mrbearnetflix/mrbearnetflix/README.md

## Netflix Connected Mr. Bear
Project site at [mrbear.netflix.com](http://mrbear.netflix.com)
