mrbearnetflix/mrbearnetflix/ee/Cellular_Bear_Schematic.pdf

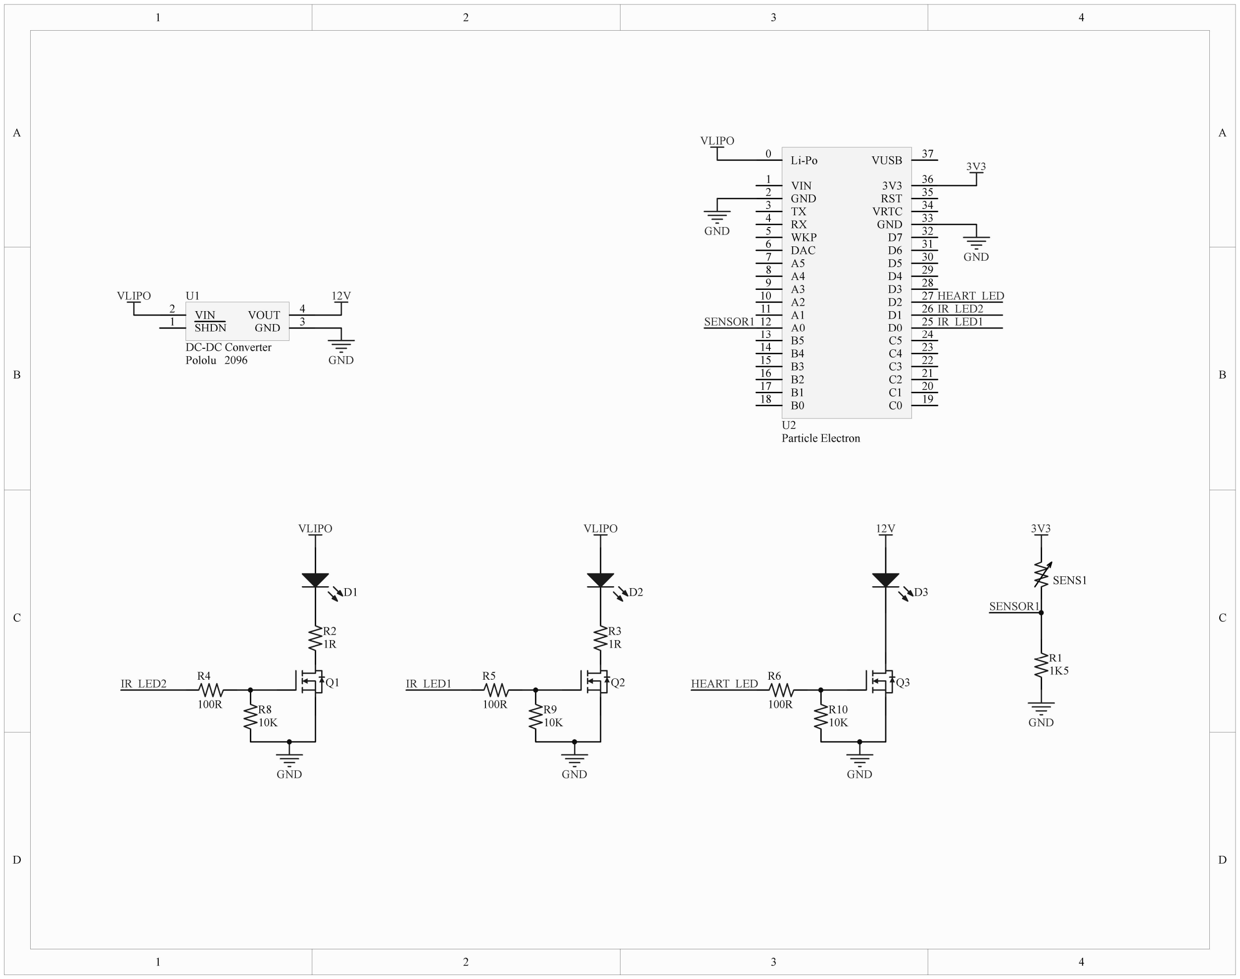
[picture p1: page 1]

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
100R

R4

10K

R8

IR_LED2 | Q1

VLIPO

100R

R5

10K

R9

IR_LED1 | Q2

VLIPO

100R

R6

10K

R10

HEART_LED | Q3

12V

GND | GND | GND

1K5

R1

GND

3V3

SENSOR1

VIN 1
GND 2
TX 3
RX 4
WKP 5
DAC 6
A5 7
A4 8
A3 9
A2 10
A1 11
A0 12
B5 13
B4 14
B3 15
B2 16
B1 17
B0 18 | C0 | 19 C1 | 20 C2 | 21 C3 | 22 C4 | 23 C5 | 24 D0 | 25 D1 | 26 D2 | 27 D3 | 28 D4 | 29 D5 | 30 D6 | 31 D7 | 32 GND | 33 VRTC | 34 RST | 35 3V3 | 36
Li-Po 0 | VUSB | 37

U2
Particle Electron

GND

GND

3V3

SENSOR1 | IR_LED1 IR_LED2

HEART_LED

Pololu 2096

VIN 2
GND | 3
VOUT | 4
SHDN 1

U1

DC-DC Converter

12V

GND

VLIPO

VLIPO

1R

R2
1R

R3

D1 | D2 | D3

SENS1
