mrbearnetflix/mrbearnetflix/enclosure/bear_switch_mount_A.STL

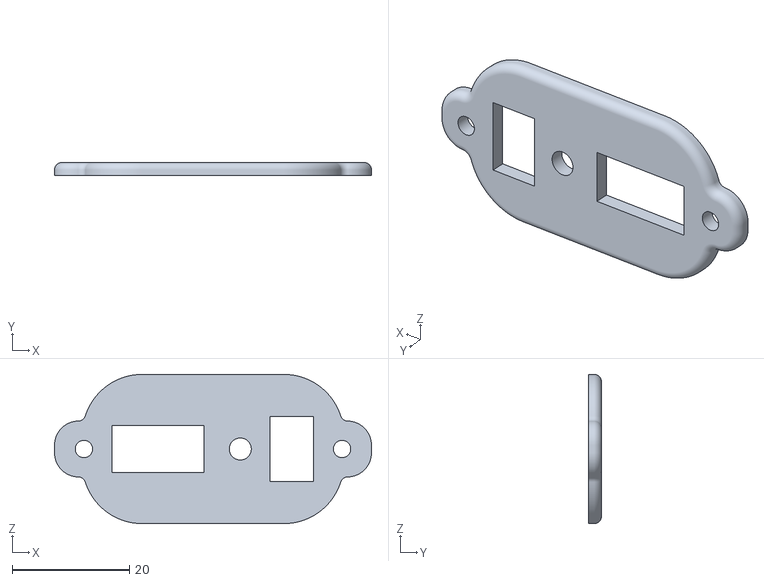
[picture p2: CAD file, 2016-12-02]
enclosure/bear_switch_mount_A.STL
54.0 x 2.22 x 25.4
