mrbearnetflix/mrbearnetflix/enclosure/bearheart_Updated Front.STL

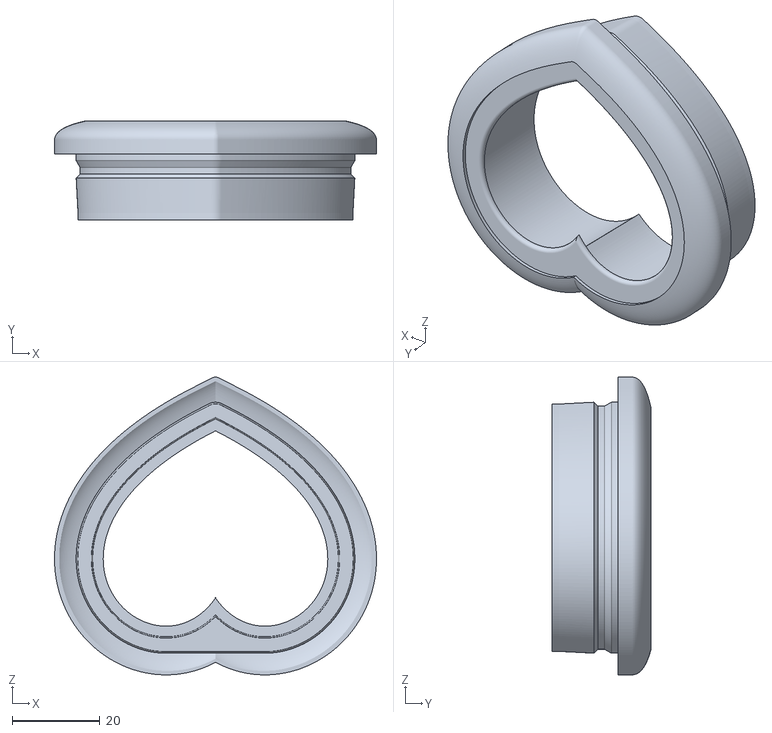
[picture p3: CAD file, 2016-12-02]
enclosure/bearheart_Updated Front.STL
73.4 x 22.6 x 67.9
