mrbearnetflix/mrbearnetflix/enclosure/bearheart_Updated Back_R2.STL

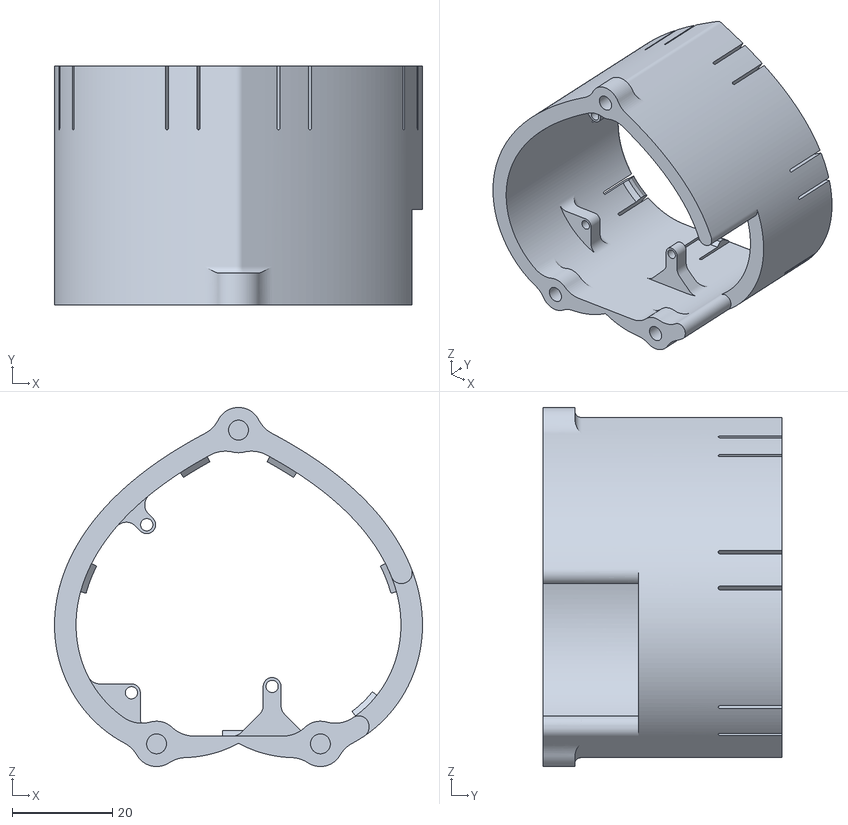
[picture p4: CAD file, 2016-12-02]
enclosure/bearheart_Updated Back_R2.STL
73.4 x 47.6 x 71.6
